cvanbibber/USB-Charger/updated_boost_USB_charger.kicad_pcb

## KiCad design updated_boost_USB_charger.kicad_pcb (2025-02-17)

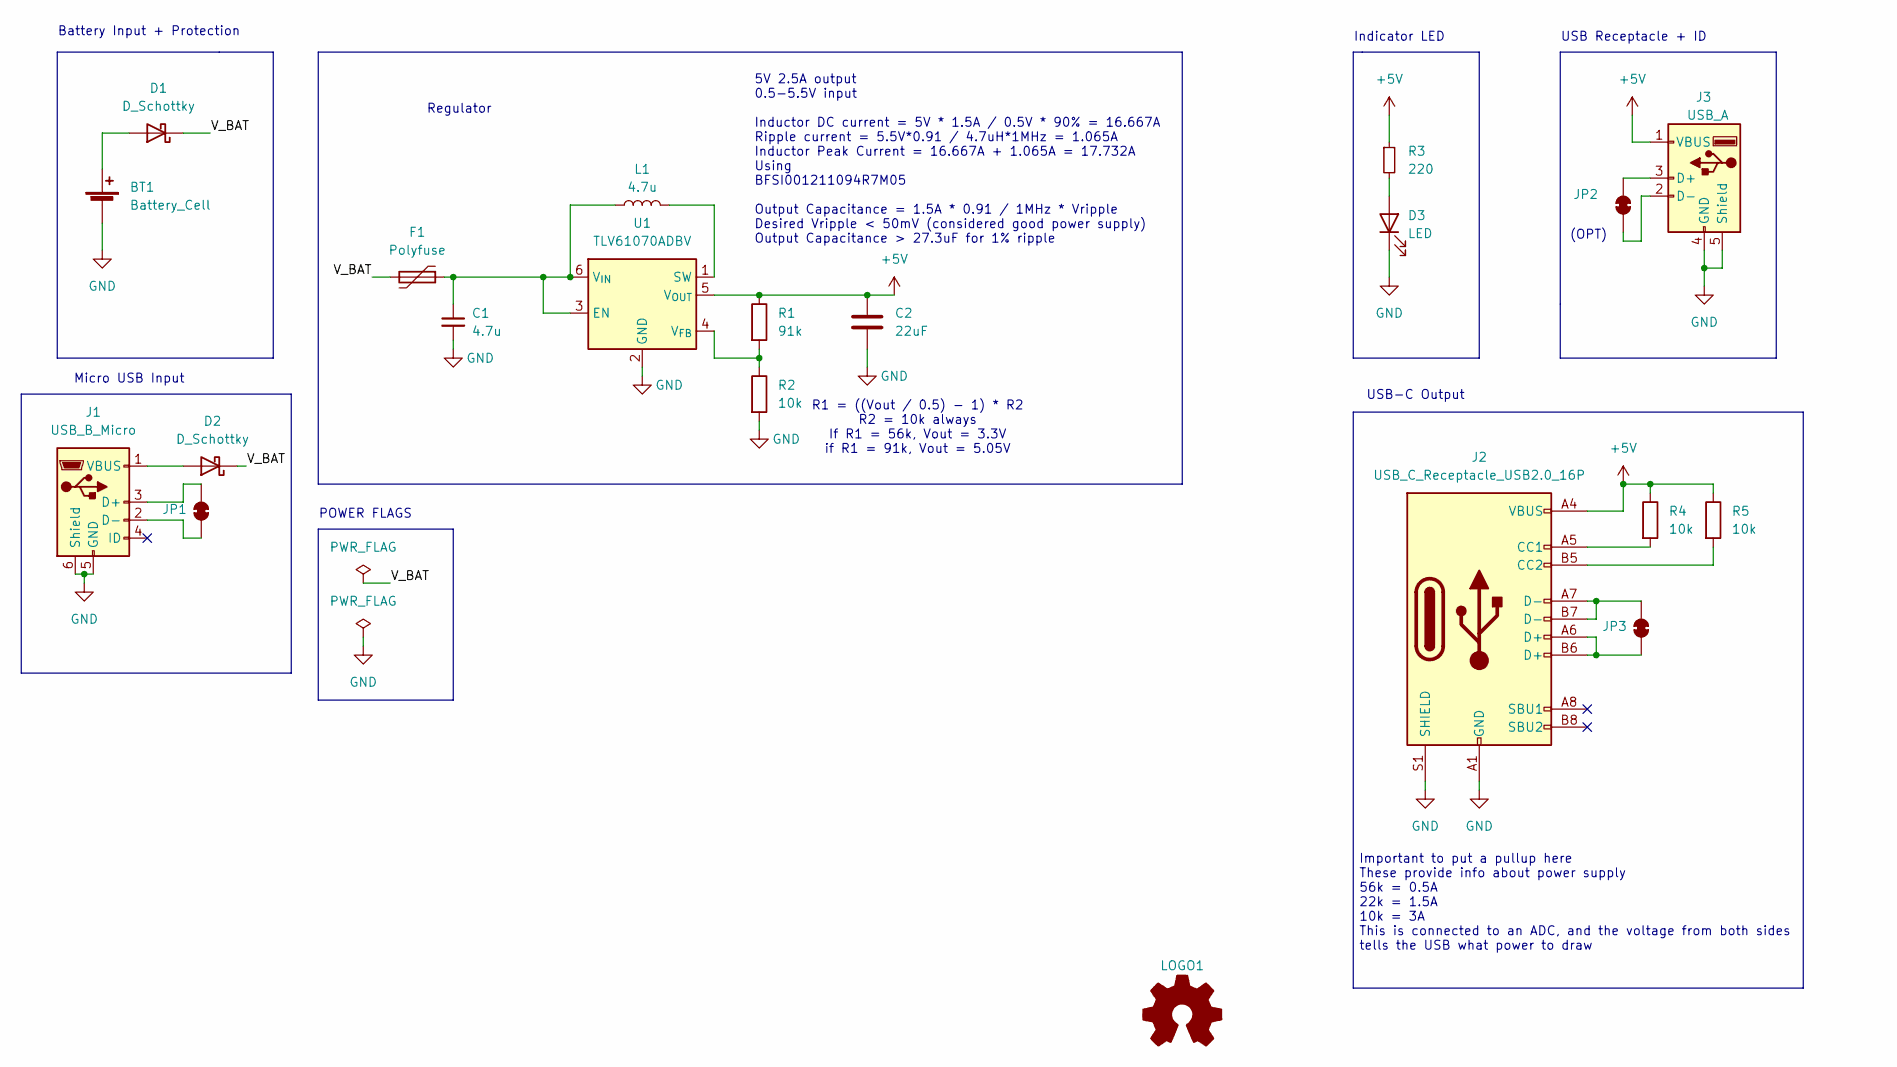
[picture p1: schematic updated_boost_USB_charger.kicad_sch]

Parts:
BT1: Battery_Cell; PinHeader_1x02_P2.54mm_Vertical; Digikey A128003CT-ND
C1: 4.7u; C_0805_2012Metric_Pad1.18x1.45mm_HandSolder; Digikey 478-0805YC106KAT2ADKR-ND
C2: 22uF; C_0603_1608Metric_Pad1.08x0.95mm_HandSolder
D1, D2: D_Schottky; D_SMA_Handsoldering
D3: LED; LED_0805_2012Metric_Pad1.15x1.40mm_HandSolder; Digikey 475-1410-6-ND
F1: Polyfuse; Fuse_1206_3216Metric_Pad1.42x1.75mm_HandSolder; Digikey 18-1812L260/16MR-ADKR-ND
J1: USB_B_Micro; CONN_10118192-0002LF_AMP
J2: USB_C_Receptacle_USB2.0_16P; USB_C_Receptacle_GCT_USB4105-xx-A_16P_TopMnt_Horizontal
J3: USB_A; USB_A_Molex_67643_Horizontal; Digikey 380-1412-ND
JP1, JP2, JP3: SolderJumper_2_Bridged; SolderJumper-2_P1.3mm_Bridged_RoundedPad1.0x1.5mm
L1: 4.7u; TMPA 1005SV-4R7MN-D
LOGO1: Logo_Open_Hardware_Small; ieee
R1: 91k; R_0603_1608Metric_Pad0.98x0.95mm_HandSolder
R2, R4, R5: 10k; R_0805_2012Metric_Pad1.20x1.40mm_HandSolder
R3: 220; R_0603_1608Metric_Pad0.98x0.95mm_HandSolder; Digikey 749-1629-6-ND
U1: TLV61070ADBV; SOT-23-6

Connections:
+5V: C2.1, J2.A4 (VBUS), J2.A9 (VBUS), J2.B4 (VBUS), J2.B9 (VBUS), J3.1 (VBUS), R1.1, R3.1, R4.1, R5.1, U1.5 (V_{OUT})
/V_BAT: D1.1 (K), D2.1 (K), F1.2
GND: BT1.2 (-), C1.2, C2.2, D3.1 (K), J1.5 (GND), J1.6 (Shield), J2.A1 (GND), J2.A12 (GND), J2.B1 (GND), J2.B12 (GND), J2.S1 (SHIELD), J3.4 (GND), J3.5 (Shield), R2.2, U1.2 (GND)
unnamed: BT1.1 (+), D1.2 (A)
unnamed: D2.2 (A), J1.1 (VBUS)
unnamed: D3.2 (A), R3.2
unnamed: J1.3 (D+), JP1.2 (B)
unnamed: J1.2 (D-), JP1.1 (A)
unnamed: J2.A5 (CC1), R4.2
unnamed: J2.B5 (CC2), R5.2
unnamed: J3.3 (D+), JP2.2 (B)
unnamed: J3.2 (D-), JP2.1 (A)
unnamed: J2.A6 (D+), J2.B6 (D+), JP3.1 (A)
unnamed: J2.A7 (D-), J2.B7 (D-), JP3.2 (B)
unnamed: C1.1, F1.1, L1.1, U1.3 (EN), U1.6 (V_{IN})
unnamed: L1.2, U1.1 (SW)
unnamed: R1.2, R2.1, U1.4 (V_{FB})

Notes on the sheet:
POWER FLAGS
Indicator LED
USB Receptacle + ID
Important to put a pullup here These provide info about power supply 56k = 0.5A 22k = 1.5A 10k = 3A This is connected to an ADC, and the voltage from both sides tells the USB what power to draw
Regulator
5V 2.5A output 0.5-5.5V input Inductor DC current = 5V * 1.5A / 0.5V * 90% = 16.667A Ripple current = 5.5V*0.91 / 4.7uH*1MHz = 1.065A Inductor Peak Current = 16.667A + 1.065A = 17.732A Using BFSI001211094R7M05 Output Capacitance = 1.5A * 0.91 / 1MHz * Vripple Desired Vripple < 50mV (considered good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
USB-C Output
Micro USB Input
(OPT)
R1 = ((Vout / 0.5) - 1) * R2 R2 = 10k always If R1 = 56k, Vout = 3.3V if R1 = 91k, Vout = 5.05V
Battery Input + Protection

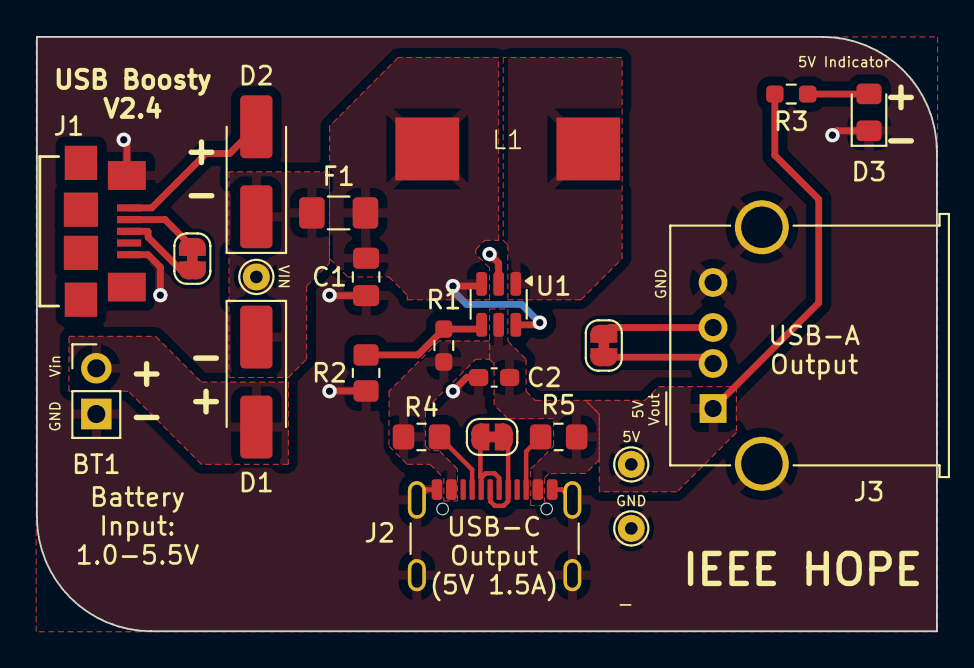
[picture p2: board updated_boost_USB_charger.kicad_pcb from above]

Board: 2 copper layers, 50.0 x 33.0 mm, 21 parts (1 on the bottom side), 17 nets.
